vlachosjm/ATCK-for-Yaesu/README.md

# ATCK-for-Yaesu
 A device to offer one button tune and programmable knobs for FTDX101D/MP and possibly others...
