vlachosjm/ATCK-for-Yaesu/ATCK Photos.pdf

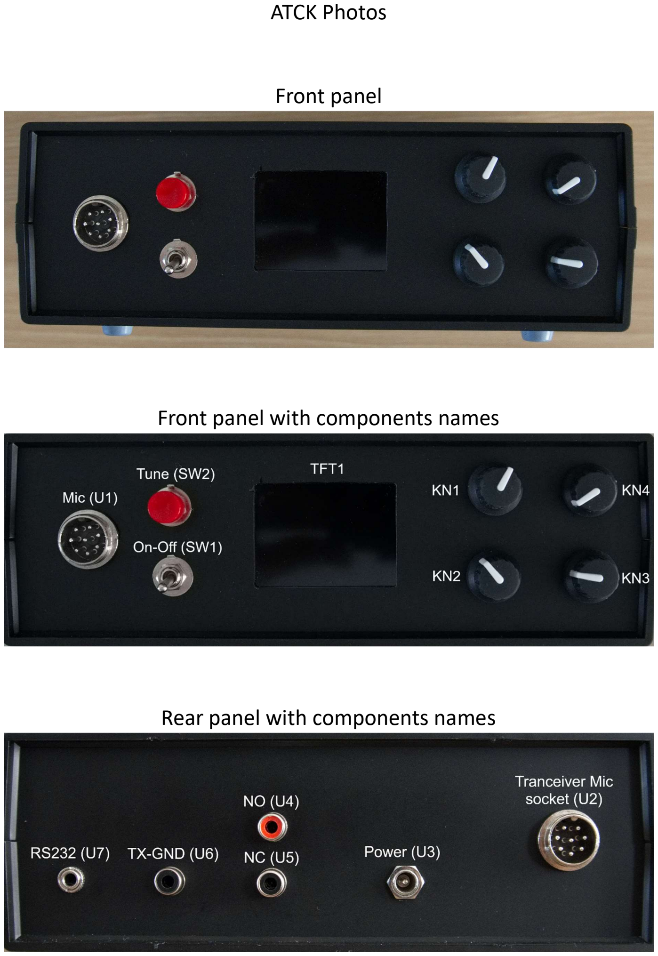
[picture p1: page 1]

ATCK Photos

Front panel

Front panel with components names

Rear panel with components names

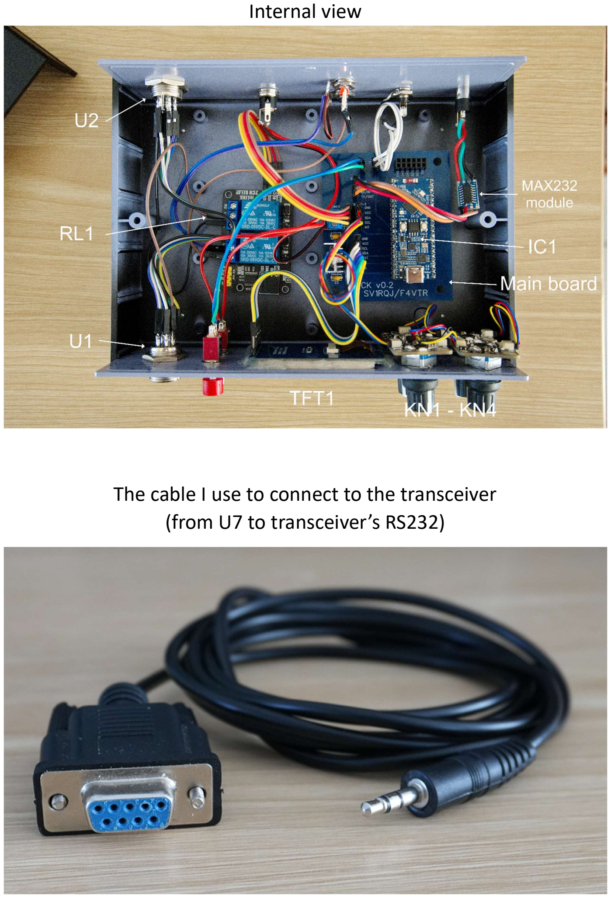
[picture p2: page 2]

Internal view

The cable I use to connect to the transceiver (from U7 to transceiver’s RS232)

The cable I use to connect from U2 to the transceiver’s Mic plug

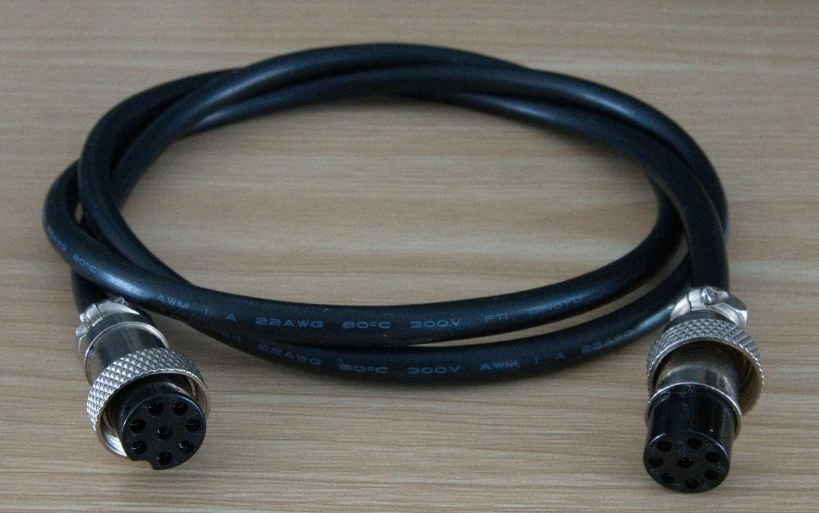
[picture p3: figure]
