vlachosjm/ATCK-for-Yaesu/ATCK schematic.pdf

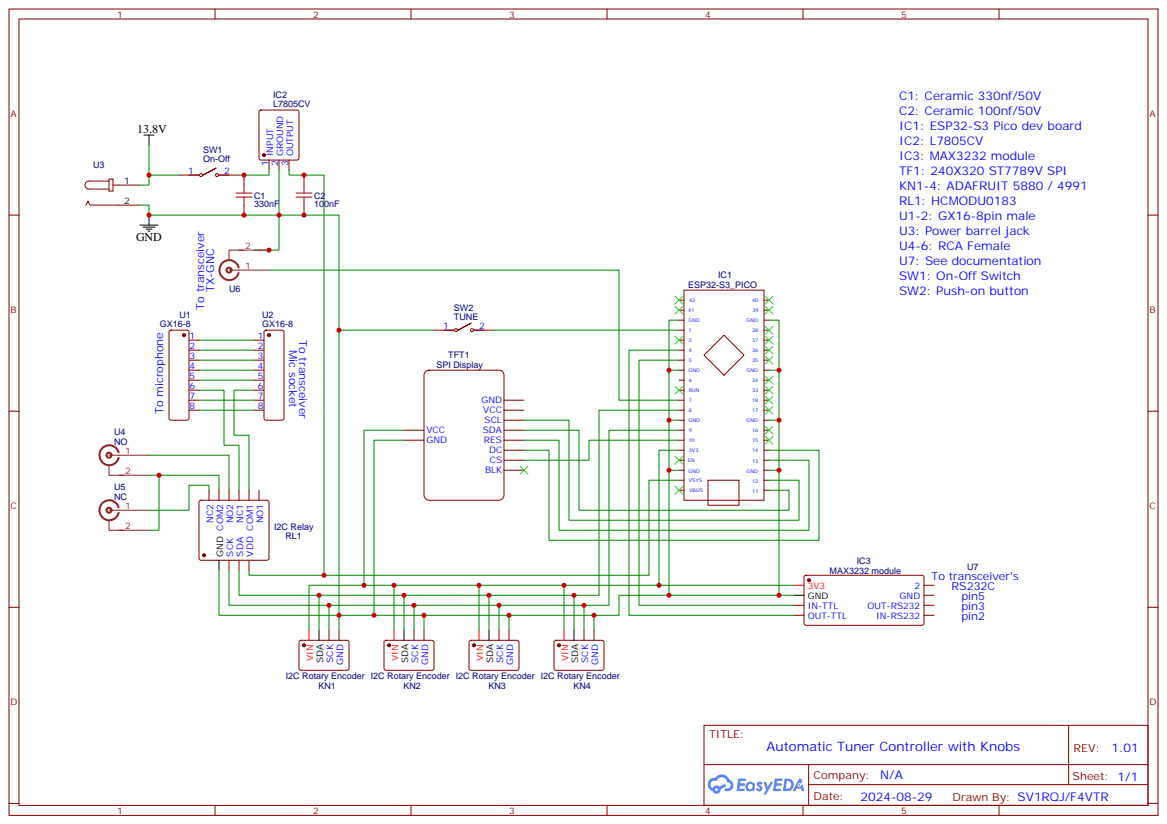
[picture p9: page 1]
