vlachosjm/ATCK-for-Yaesu/(commit log)

2024-08-30 Bug fixing and clean up
    Bugs fixed:
    The system menu was staying indefinitely on screen if nothing was selected.
    When the knobs where turning fast, some steps where not counted (missing clicks)
    Cleaned up unneeded variables.
    [ATCK-for-Yaesu.ino]
2024-09-01 New feature (Transmit Time) and bug fixing
    Add functionality:
    Set a transmit time (in the system menu).
    When you transmit, and you pass the 80% of the set transmit time, the shown timer on the display turns red.
    You can transmit past the time you have set. It's only informative.
    Bug correction:
    When exiting the System Menu the display was showing the set power level in big character.
    When exiting the System Menu the code that was handling the rotation of the first rotary encoder was activated, changing the value of the paramater assinged to the encoder.
    [ATCK-for-Yaesu.ino]
2024-09-17 New functionality and bug corrections
    Reconstructed the System Menu
    Added 2nd relay functionality and paramaters
    Bug corrections
    [ATCK-for-Yaesu.ino]
2024-09-21 Added missing file
    File User_Setup.h added
    [User_Setup.h]
2025-01-04 Update ATCK-for-Yaesu.ino
    Spelling errors correction
    [ATCK-for-Yaesu.ino]
2026-06-13 Revert "More information displayed"
    This reverts commit 246897c7d778cdc4d6ba12d4273647d879447cba.
    [ATCK-for-Yaesu.ino, User_Setup.h]
2026-08-05 Various improvements
    Better use of the second core:
    Move the control of the push button to the second core in order to make the system more responsive.
    Various small code improvements.
